Michael-Q-Ly/STM32_BluePill_Clone/README.md

# KiCad V6 STM32 Blue Pill Hardware Design
