Michael-Q-Ly/STM32_BluePill_Clone/Models/629105150521.stp

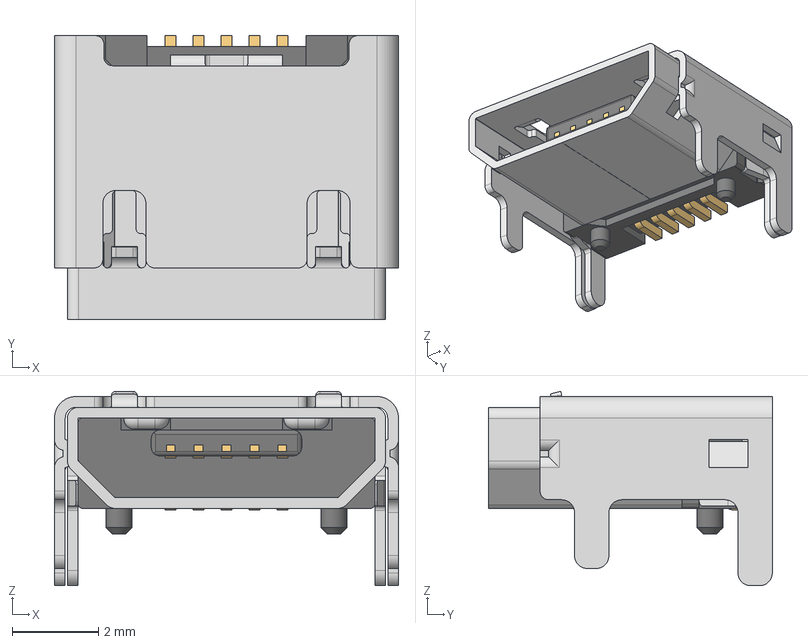
[picture p1: CAD file, 2022-12-17]
Models/629105150521.stp
8.00 x 6.60 x 4.52 mm
629105150521_Housing
629105150521_Pin1 x 4
629105150521_Pin2
629105150521_Shielding2
629105150521_Shielding
