Michael-Q-Ly/STM32_BluePill_Clone/(commit log)

2022-12-10 Create new KiCad project
    [STM32_Bluepill.kicad_pcb, STM32_Bluepill.kicad_sch]
2022-12-10 Schematic: Add MCU and decoupling caps / bulk caps
    - Also add VDD and VDDA
    [STM32_Bluepill.kicad_sch]
2022-12-10 Schematic: Add Configuration pins NRST and BOOT0
    - Add a switch for BOOT0 to allow it to be programmed
    - NRST should already have an internal pullup
    [STM32_Bluepill.kicad_sch]
2022-12-10 Schematic: Add Pin-out net names
    - HSE_IN, HSE_OUT
    - USB_D-, USB_D+ (Same name & -/+ signifies differential pair)
    - SWDIO
    - SWCLK
    [STM32_Bluepill.kicad_sch]
2022-12-10 Schematic: Add crystal circuitry
    - STM has a crystal design guide - Application Note # AN2867
    - 10 pF crystal with a stray capacitance of 3-5 pF gives us
    around 5pF, multiplying by 2 gives 10pF caps attached to the
    crystal
    - Calculating these caps also found in the datasheet
    [STM32_Bluepill.kicad_sch]
2022-12-10 Schematic: Add USB B Micro and STM USB app note
    - Use USB App note from STM to get what pullup resistor value to
    use on the USB_D+ line
    [STM32_Bluepill.kicad_sch]
2022-12-10 Schematic: Add power supply and connectors
    - 3.3V Linear regulator with PWR_LED
    - Connectors for USART and I2C
    - Many resistors are 1.5k to save on the BOM
    [STM32_Bluepill.kicad_sch]
2022-12-10 Schematic: Annotate and add notes and run ERC; also add PWR_FLAG
    [STM32_Bluepill.kicad_sch]
2022-12-10 Schematic: Fix wrong cap value in VDDA Filtering from 10nF to 1uF
    [STM32_Bluepill.kicad_sch]
2022-12-10 Schematic: Change LED name to RED
    [STM32_Bluepill.kicad_sch]
2022-12-10 Schematic: Assign footprints to schematic symbols
    [STM32_Bluepill.kicad_sch]
2022-12-11 Layout: Specify Board Settings from OSHPARK
    [STM32_Bluepill.kicad_pcb]
2022-12-11 Layout: Add Rat's Nest and edit page info
    [STM32_Bluepill.kicad_pcb]
2022-12-15 Begin routing by importing rat's nest
    [STM32_Bluepill.kicad_pcb]
2022-12-15 Layout: Layout decoupling caps, filtering, and oscillator
    [STM32_Bluepill.kicad_pcb]
2022-12-17 Layout: Place USB and SWD (Serial Wirte Debugger)
    [STM32_Bluepill.kicad_pcb]
2022-12-17 Layout: Change switch's footprint to be a smaller SMD one
    [STM32_Bluepill.kicad_pcb]
2022-12-17 Layout: Add 3D model/stp file of USB connector
    [629105150521.stp]
2022-12-17 Layout: replace 3D model with new USB connector
    - You can do this by looking up the part number in the schematic
    and then going to a site such as Digi-Key and downloading its
    3D CAD model
    - Offset y- and z- axes by 1.000 mm to get the pads to align
    [STM32_Bluepill.kicad_pcb]
2022-12-17 Schematic: Rename SW_BOOT1 to SW_1 and add net label called SW_BOOT1
    [STM32_Bluepill.kicad_sch]
2022-12-17 Layout: Place switch and connectors
    [STM32_Bluepill.kicad_pcb]
2022-12-17 Layout: Place power supplies and bulk cap
    [STM32_Bluepill.kicad_pcb]
2022-12-17 Schematic: Add M2 mounting holes
    [STM32_Bluepill.kicad_sch]
2022-12-17 Layout: Add mounting holes and edge cuts
    [STM32_Bluepill.kicad_pcb]
2022-12-17 Routing: Do ground pour
    [STM32_Bluepill.kicad_pcb]
2022-12-17 Routing: Route decoupling caps first then XTL HSE_IN/OUT
    [STM32_Bluepill.kicad_pcb]
2022-12-17 Schematic/Layout: Rename SW_BOOT1 to SW_BOOT0 for net name
    [STM32_Bluepill.kicad_sch]
2022-12-17 Routing: Route signals
    [STM32_Bluepill.kicad_pcb]
2022-12-18 Routing: Route PWR and GND
    - Use 0.5 mm tracks for these
    - Create fills for grouped GND or PWR
    - Move some things around to accommodate
    [STM32_Bluepill.kicad_pcb]
2022-12-18 Silkscreen: Put markings to indicate pin 1 on components + run DRC
    [STM32_Bluepill.kicad_pcb]
2022-12-18 Add duck image for silkscreen
2022-12-18 Silkscreen: Add custom duck image and board details on back of board
    [STM32_Bluepill.kicad_pcb]
2022-12-18 Routing: Fix a 0.3 mm 3V3 trace to a 0.5 mm trace
    [STM32_Bluepill.kicad_pcb]
2022-12-18 Manufacturing: Add BOM, gerber, and drill files & archive them
    [STM32_Bluepill-B_Cu.gbr, STM32_Bluepill-B_Mask.gbr, STM32_Bluepill-B_Paste.gbr, STM32_Bluepill-B_Silkscreen.gbr, STM32_Bluepill-Edge_Cuts.gbr, STM32_Bluepill-F_Cu.gbr, STM32_Bluepill-F_Mask.gbr, STM32_Bluepill-F_Paste.gbr]
2022-12-18 Routing: Turn R5 to make routing easier
    [STM32_Bluepill.kicad_pcb]
2022-12-18 Manufacturing: Regenerate position, drill, and gerber files after R5 rotation
    [STM32_Bluepill-B_Cu.gbr, STM32_Bluepill-B_Mask.gbr, STM32_Bluepill-B_Paste.gbr, STM32_Bluepill-B_Silkscreen.gbr, STM32_Bluepill-Edge_Cuts.gbr, STM32_Bluepill-F_Cu.gbr, STM32_Bluepill-F_Mask.gbr, STM32_Bluepill-F_Paste.gbr]
